Balaji-008/automated-color-based-gem-sorting-system/(commit log)

2026-05-26 initial commit: add automated color-based gem sorting system firmware, images, schematic, pcb layout, and report
2026-05-27 Update color sensor label in README
